Daxxn/MicLight/Docs/MicLight_Schematic_REV5.pdf

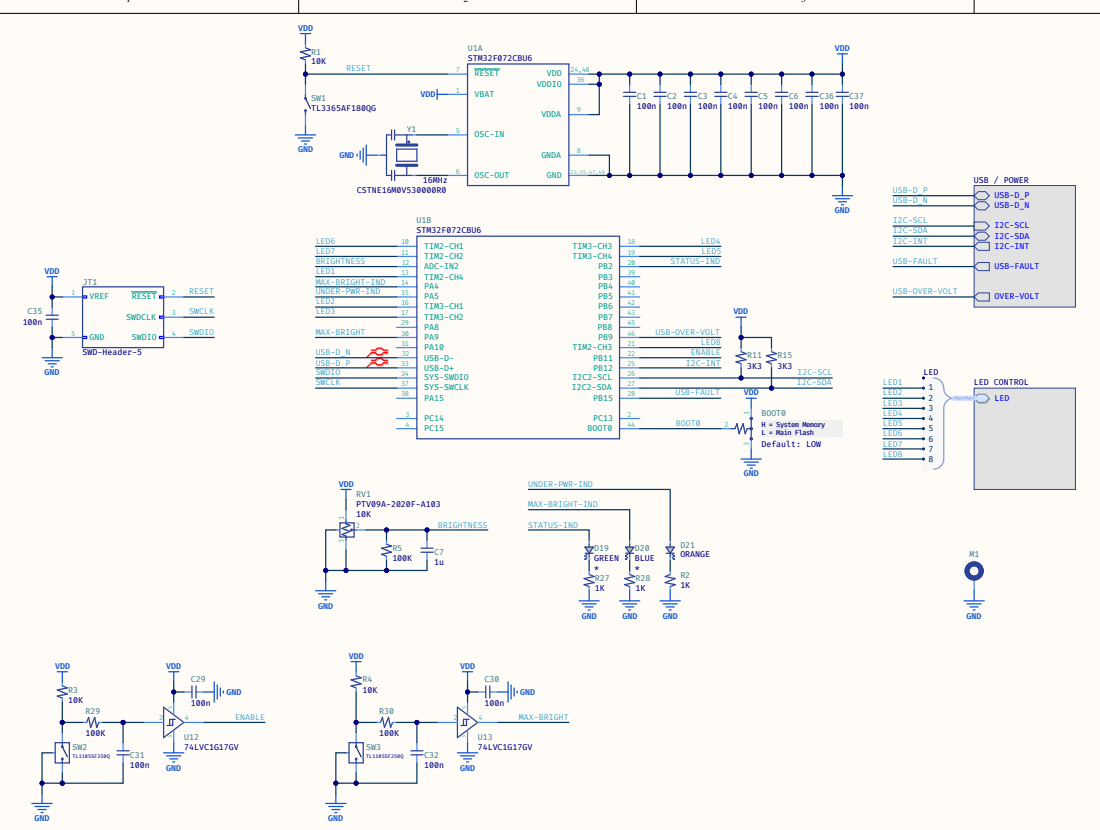
[picture p1: page 1]

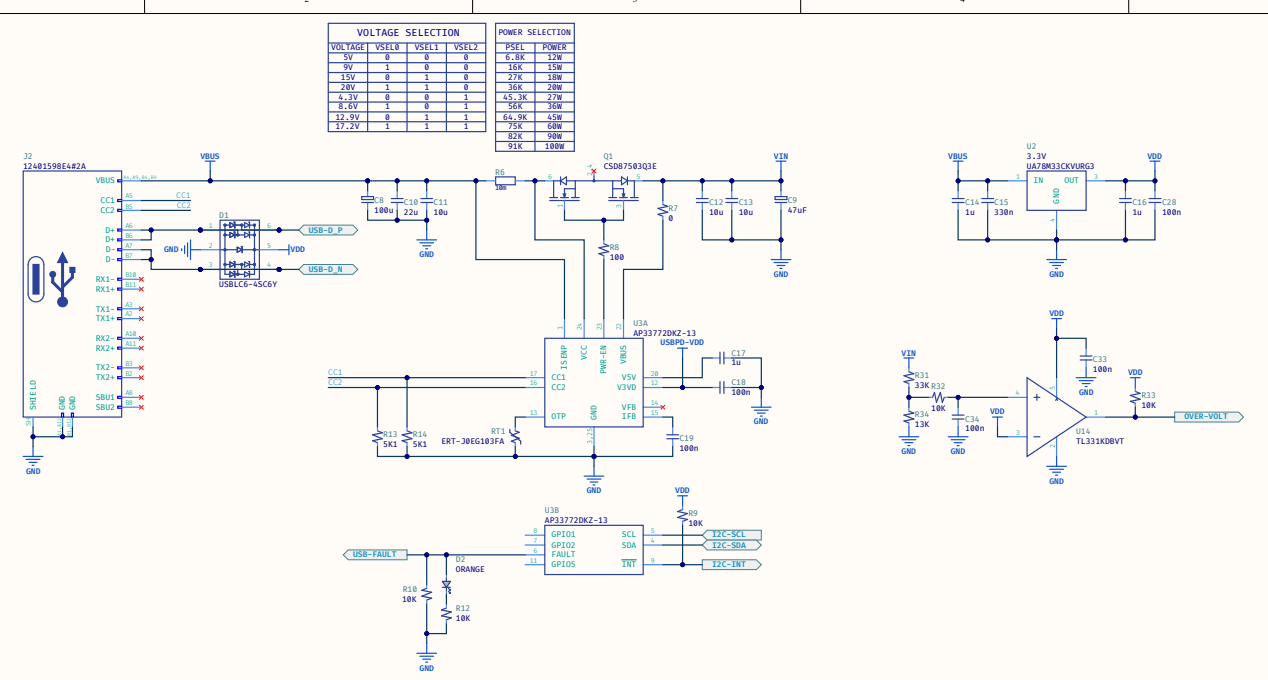
[picture p2: page 2]

V O L T A G E S E L E T I O N | POWER SELECTION
VOLTAGE | | | | PSEL | POWER
5V | | | | 6.8K | 12W

9V | VSEL0 | VSEL1 | VSEL2 00001111 11000011 01010101 | 16K | 15W

15V | | | | 27K | 18W
20V | | | | 36K | 20W
4.3V | | | | 45.3K | 27W
8.6V | | | | 56K | 36W
12.9V | | | | 64.9K | 45W
17.2V | | | | 75K | 60W

82K | 90W
91K | 100W

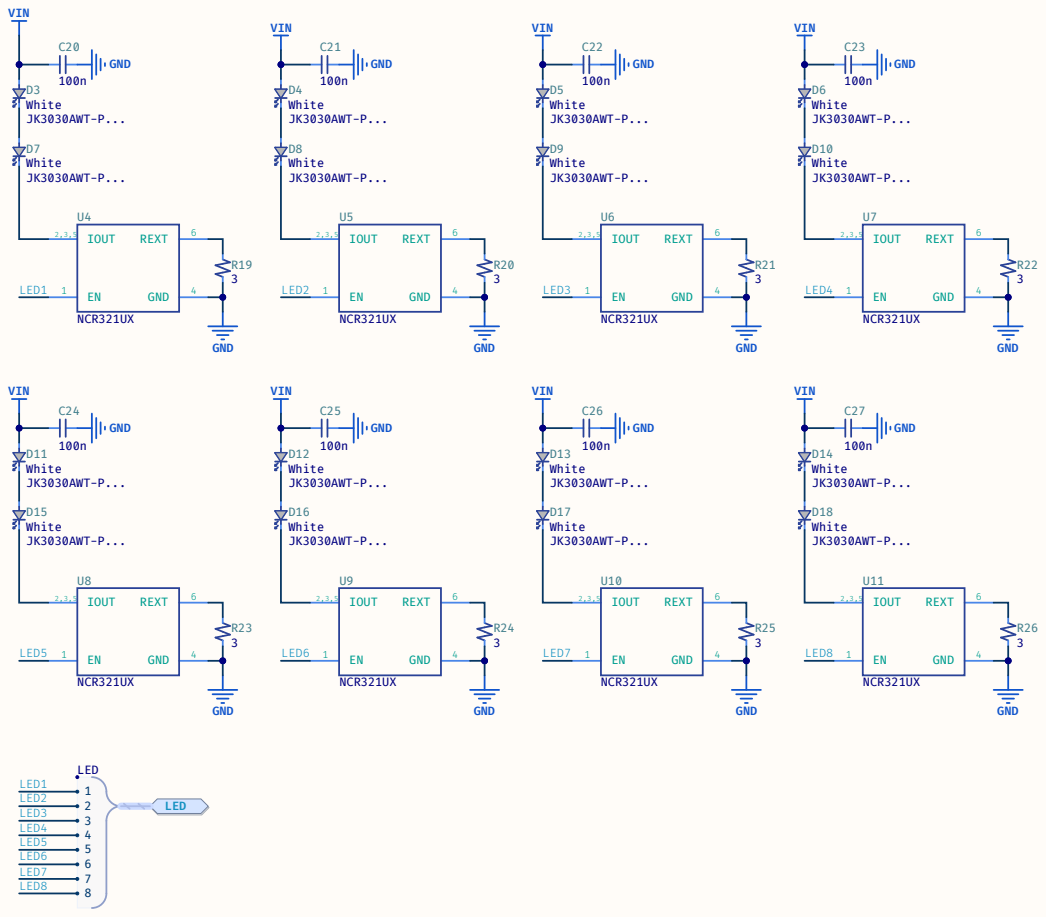
[picture p3: page 3]

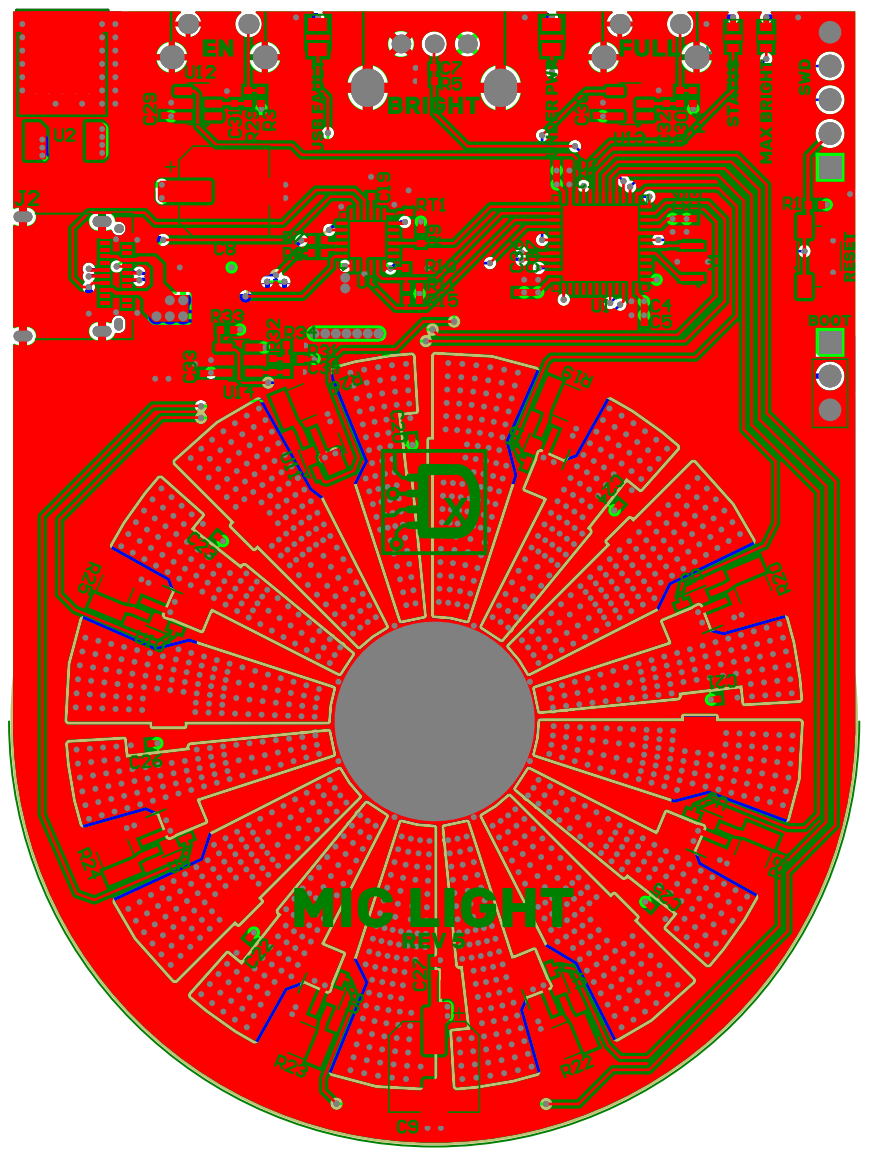
[picture p4: page 4]
