Daxxn/MicLight/MicLightREV5.ioc

Mcu.UserName=STM32F072CBUx
PA0.GPIO_Label=LED6
PA0.Signal=S_TIM2_CH1_ETR
PA1.GPIO_Label=LED7
PA1.Signal=S_TIM2_CH2
PA11.Signal=USB_DM
PA12.Signal=USB_DP
PA13.Signal=SYS_SWDIO
PA14.Signal=SYS_SWCLK
PA2.GPIO_Label=BRIGHTNESS
PA2.Signal=ADC_IN2
PA3.GPIO_Label=LED1
PA3.Signal=S_TIM2_CH4
PA4.GPIO_Label=MAX_BRIGHT_IND
PA4.Signal=GPIO_Output
PA5.GPIO_Label=UNDER_PWR_IND
PA5.Signal=GPIO_Output
PA6.GPIO_Label=LED2
PA6.Signal=S_TIM3_CH1
PA7.GPIO_Label=LED3
PA7.Signal=S_TIM3_CH2
PA9.GPIO_Label=MAX_BRIGHT
PA9.Signal=GPXTI9
PB0.GPIO_Label=LED4
PB0.Signal=S_TIM3_CH3
PB1.GPIO_Label=LED5
PB1.Signal=S_TIM3_CH4
PB10.GPIO_Label=LED8
PB10.Signal=S_TIM2_CH3
PB11.GPIO_Label=ENABLE
PB11.Signal=GPXTI11
PB12.GPIO_Label=I2C_INT
PB12.Signal=GPXTI12
PB13.Signal=I2C2_SCL
PB14.Signal=I2C2_SDA
PB15.GPIO_Label=USB_FAULT
PB15.Signal=GPIO_Input
PB2.GPIO_Label=STATUS_IND
PB2.Signal=GPIO_Output
PB9.GPIO_Label=USB_OVER_VOLT
PB9.Signal=GPIO_Input
PF0-OSC_IN.Signal=RCC_OSC_IN
PF1-OSC_OUT.Signal=RCC_OSC_OUT
