Daxxn/MicLight/Core/Src/main.c

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
/* Includes ------------------------------------------------------------------*/
#include "main.h"
#include "usb_device.h"

ADC_HandleTypeDef hadc;

I2C_HandleTypeDef hi2c2;

TIM_HandleTypeDef htim2;
TIM_HandleTypeDef htim3;
TIM_HandleTypeDef htim7;
TIM_HandleTypeDef htim14;
TIM_HandleTypeDef htim15;
TIM_HandleTypeDef htim16;

void SystemClock_Config(void);
static void MX_GPIO_Init(void);
static void MX_I2C2_Init(void);
static void MX_TIM2_Init(void);
static void MX_TIM3_Init(void);
static void MX_ADC_Init(void);
static void MX_TIM7_Init(void);
static void MX_TIM14_Init(void);
static void MX_TIM15_Init(void);
static void MX_TIM16_Init(void);
/* USER CODE BEGIN 0 */
void HAL_ADC_ConvCpltCallback(ADC_HandleTypeDef* hadc)
{
	ADCConvCallback();
}

void HAL_GPIO_EXTI_Callback(uint16_t GPIO_Pin)
{
	ExtInterruptCallback(GPIO_Pin);
}

void HAL_TIM_PeriodElapsedCallback(TIM_HandleTypeDef *htim)
{
	TimerElapsedCallback(htim);
}
/* USER CODE END 0 */

/**
  * @brief  The application entry point.
  * @retval int
  */
int main(void)
{

  /* MCU Configuration--------------------------------------------------------*/

  /* Reset of all peripherals, Initializes the Flash interface and the Systick. */
  HAL_Init();

  /* Configure the system clock */
  SystemClock_Config();

  /* Initialize all configured peripherals */
  MX_GPIO_Init();
  MX_I2C2_Init();
  MX_TIM2_Init();
  MX_TIM3_Init();
  MX_ADC_Init();
  MX_USB_DEVICE_Init();
  MX_TIM7_Init();
  MX_TIM14_Init();
  MX_TIM15_Init();
  MX_TIM16_Init();
  /* USER CODE BEGIN 2 */
  if (Init(&hadc, &htim2, &htim3, &htim7, &htim14, &htim15, &htim16, &hi2c2) != HAL_OK) {
	return HAL_ERROR;
  }
  /* USER CODE END 2 */

  /* Infinite loop */
  /* USER CODE BEGIN WHILE */
  while (1)
  {
	  Main();
    /* USER CODE END WHILE */

    /* USER CODE BEGIN 3 */
  }
  /* USER CODE END 3 */
}

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
