Daxxn/MicLight/Core/Inc/LightingControl.h

/*
 * LightingControl.h
 *
 *  Created on: Mar 30, 2024
 *      Author: Daxxn
 */

#ifndef INC_LIGHTINGCONTROL_H_
#define INC_LIGHTINGCONTROL_H_

//#include "main.h"
//
//#define LED_COUNT 8
//
//const double UINT16_MAXF = 65535.0;
//const double UINT12_MAXF = 4095.0;
//
//typedef struct {
//	uint8_t ch;
//	TIM_HandleTypeDef *handle;
//} PWMPinDef;
//
//typedef struct {
//	PWMPin *pins;
//} LightingState;
//
//HAL_StatusTypeDef InitLighting(PWMPin *pins);
//void DeInitLighting();
//
//void LightsOff();
//void LightsOn();
//void SetLight(uint8_t index, uint16_t pwm);
//void SetAllLights(uint16_t pwm);
//void SetMaxBrightness();


#endif /* INC_LIGHTINGCONTROL_H_ */
